L00rdD/bifrost/dashboard/bifrost-discord.png

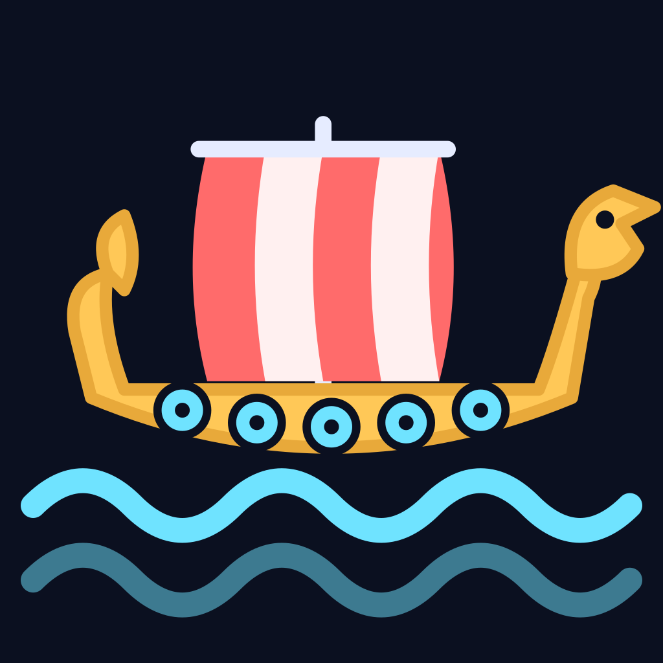
dashboard/bifrost-discord.png
