L00rdD/bifrost/dashboard/bifrost.png

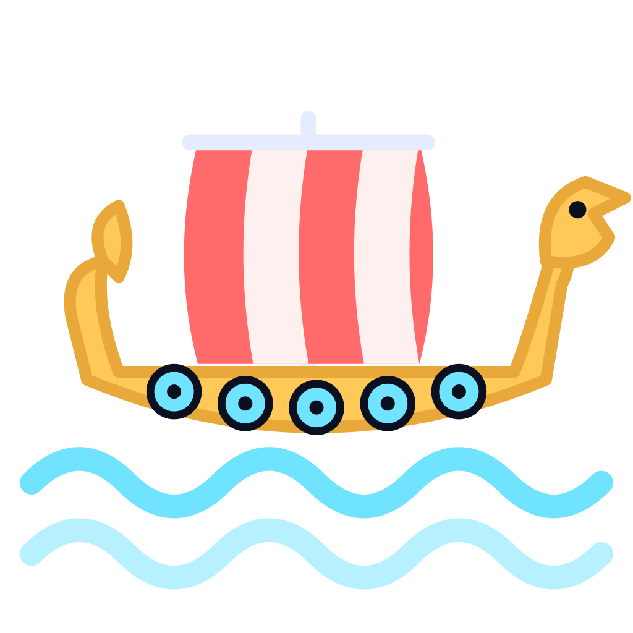
dashboard/bifrost.png
