L00rdD/bifrost/enclosure/renders/front.png

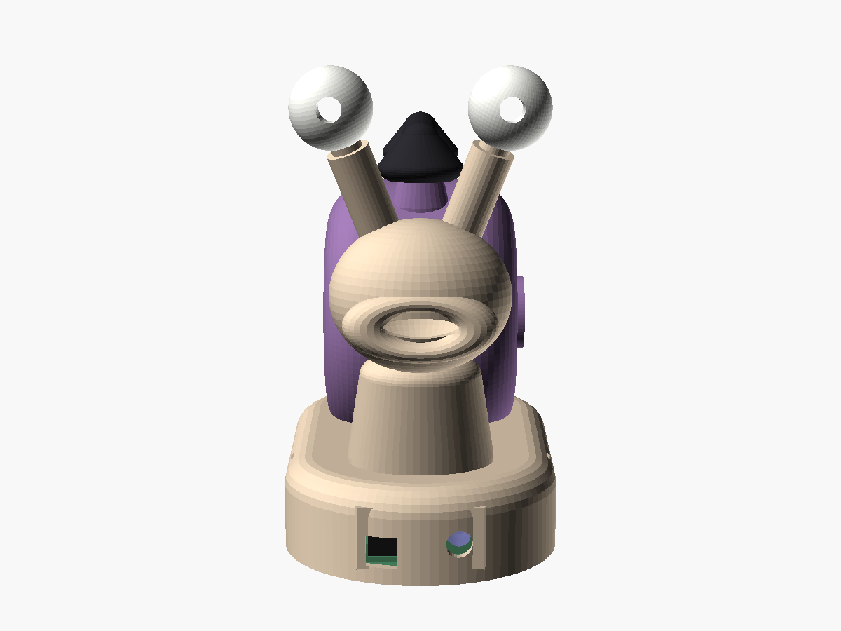
enclosure/renders/front.png
