L00rdD/bifrost/enclosure/renders/right.png

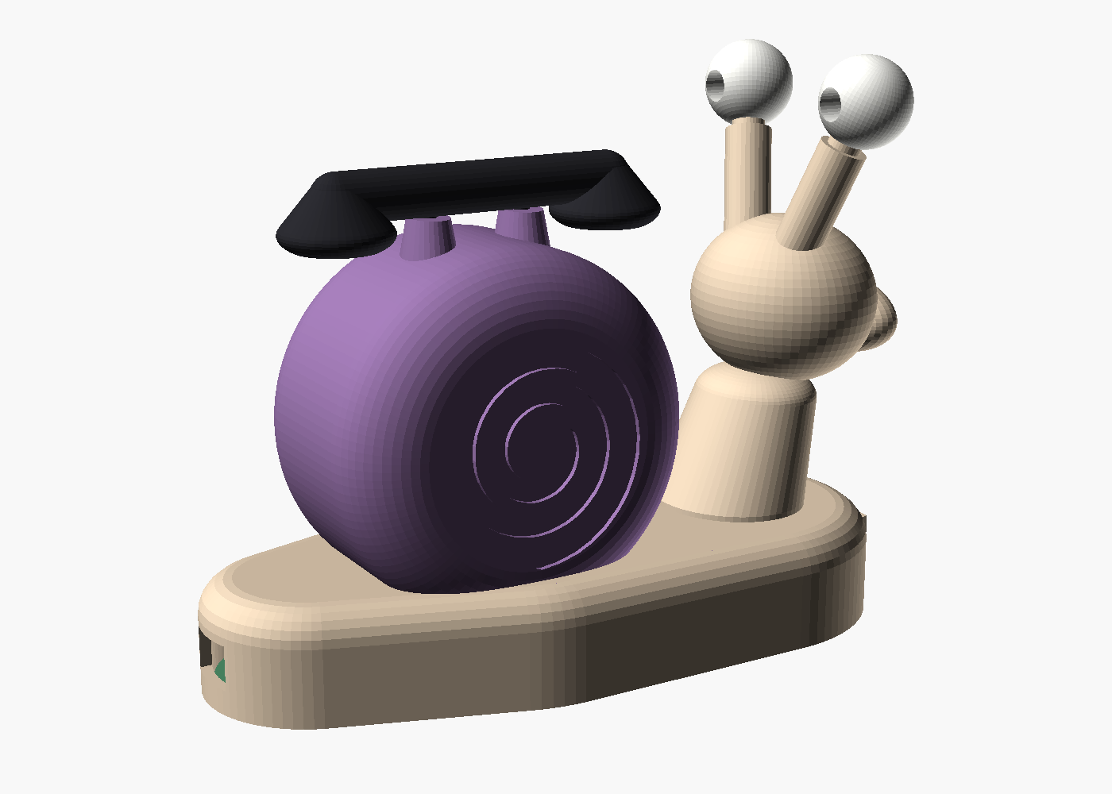
enclosure/renders/right.png
