L00rdD/bifrost/enclosure/shanks/out/all_back.png

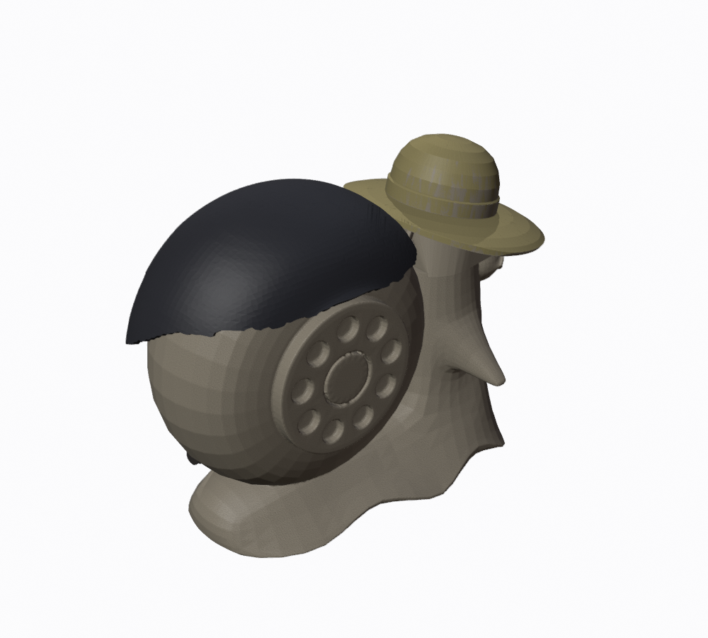
enclosure/shanks/out/all_back.png
