L00rdD/bifrost/enclosure/shanks/out/all_front.png

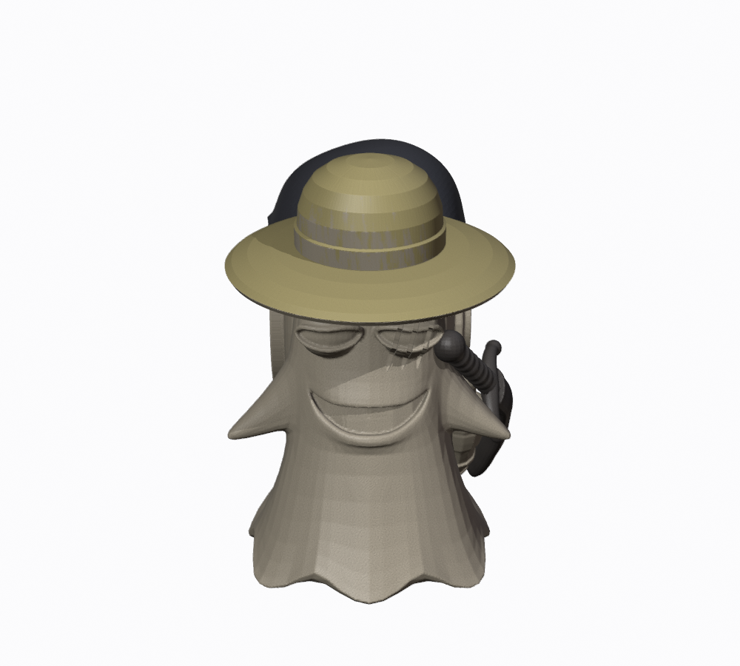
enclosure/shanks/out/all_front.png
