L00rdD/bifrost/enclosure/shanks/out/all_left.png

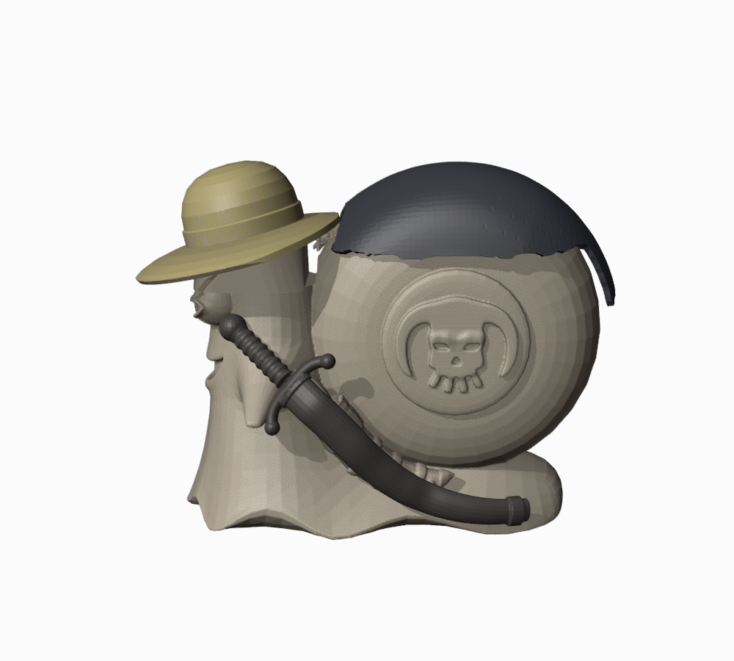
enclosure/shanks/out/all_left.png
