L00rdD/bifrost/enclosure/shanks/out/all_right.png

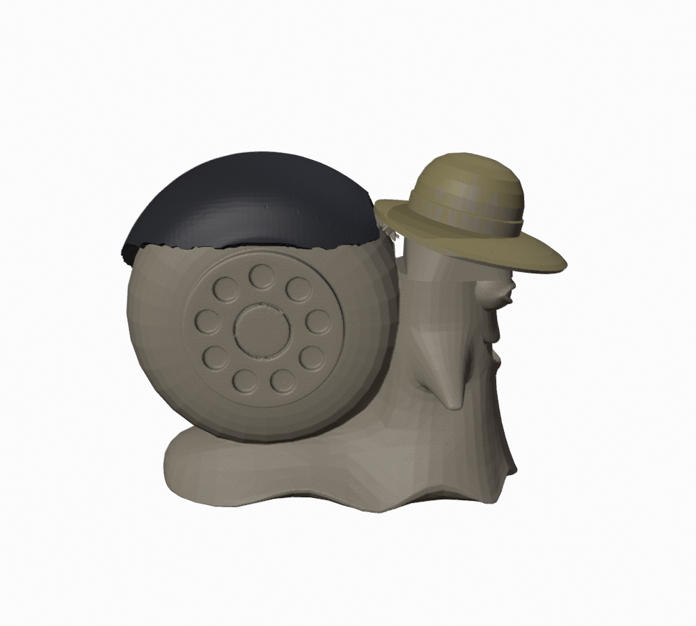
enclosure/shanks/out/all_right.png
