L00rdD/bifrost/enclosure/shanks/out/all_sword.png

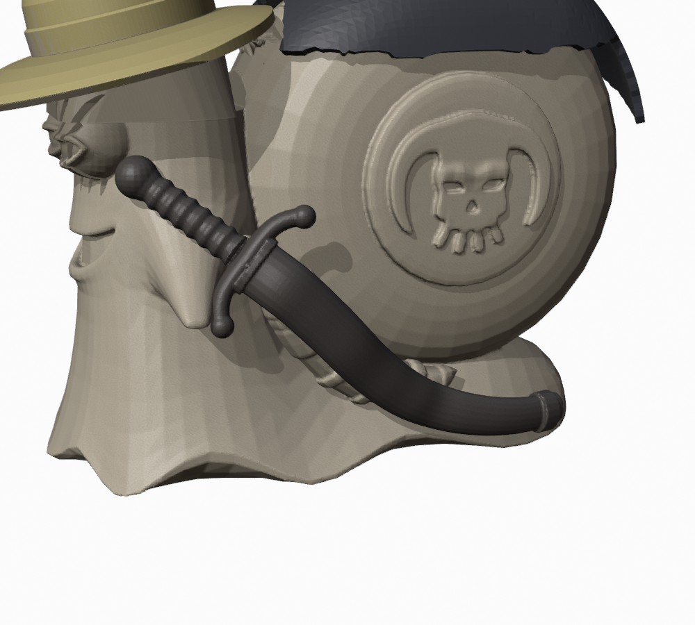
enclosure/shanks/out/all_sword.png
