L00rdD/bifrost/enclosure/shanks/out/all_three.png

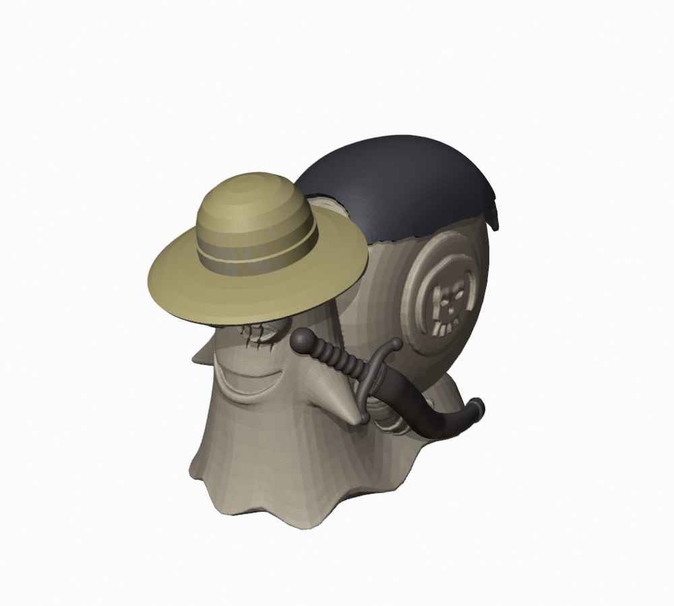
enclosure/shanks/out/all_three.png
