L00rdD/bifrost/enclosure/shanks/out/cape_back.png

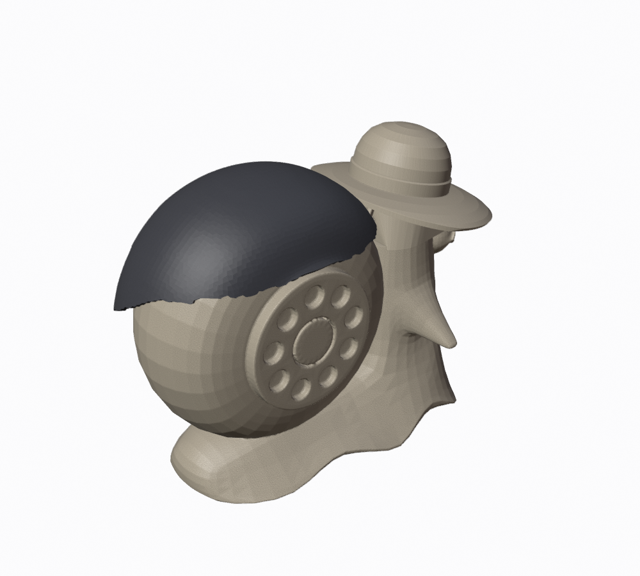
enclosure/shanks/out/cape_back.png
