L00rdD/bifrost/enclosure/shanks/out/cape_other.png

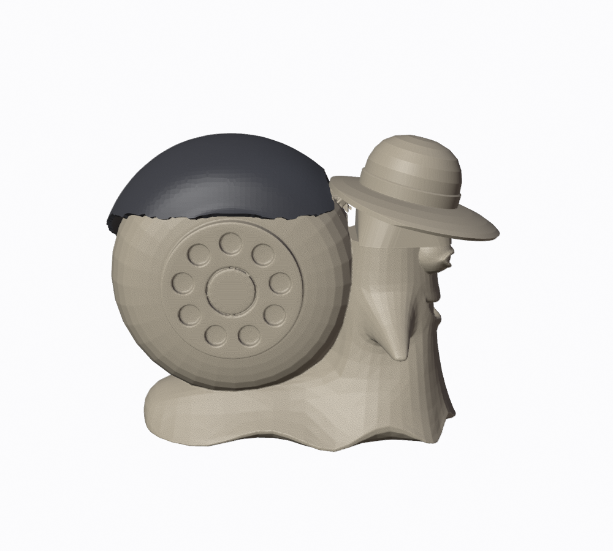
enclosure/shanks/out/cape_other.png
