L00rdD/bifrost/enclosure/shanks/out/cape_side.png

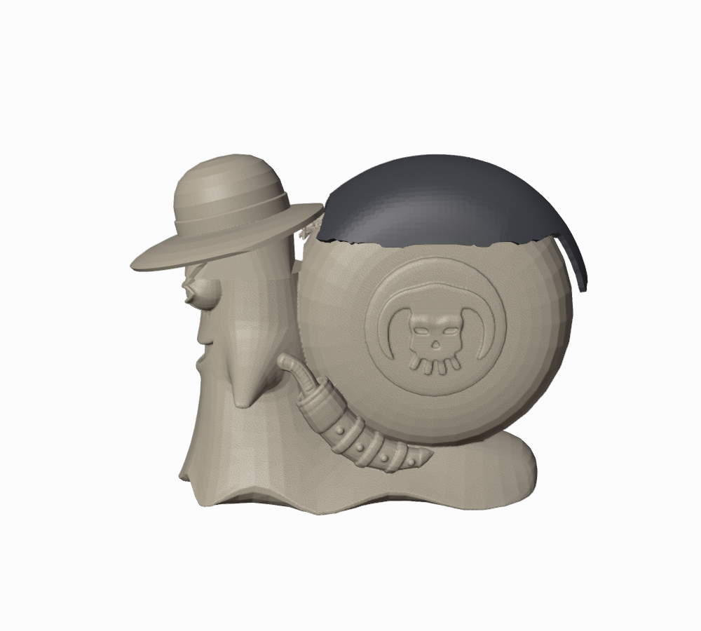
enclosure/shanks/out/cape_side.png
