L00rdD/bifrost/enclosure/shanks/out/preview_back.png

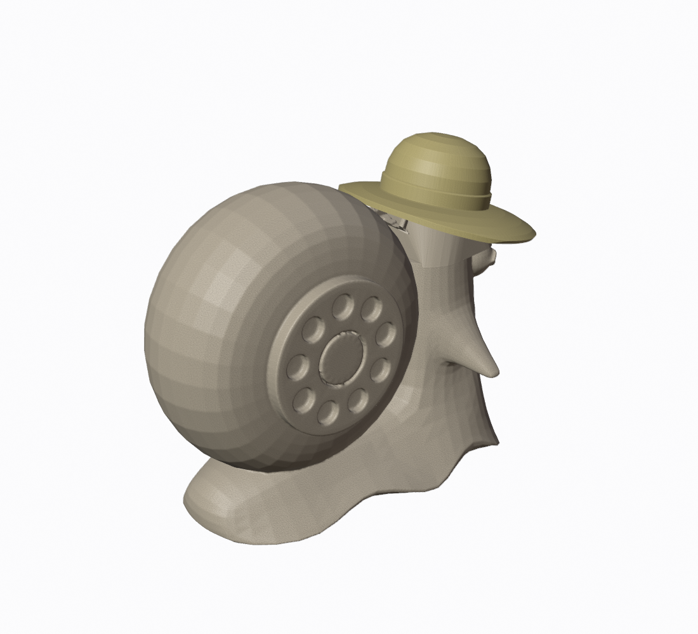
enclosure/shanks/out/preview_back.png
