L00rdD/bifrost/enclosure/shanks/out/preview_back_close.png

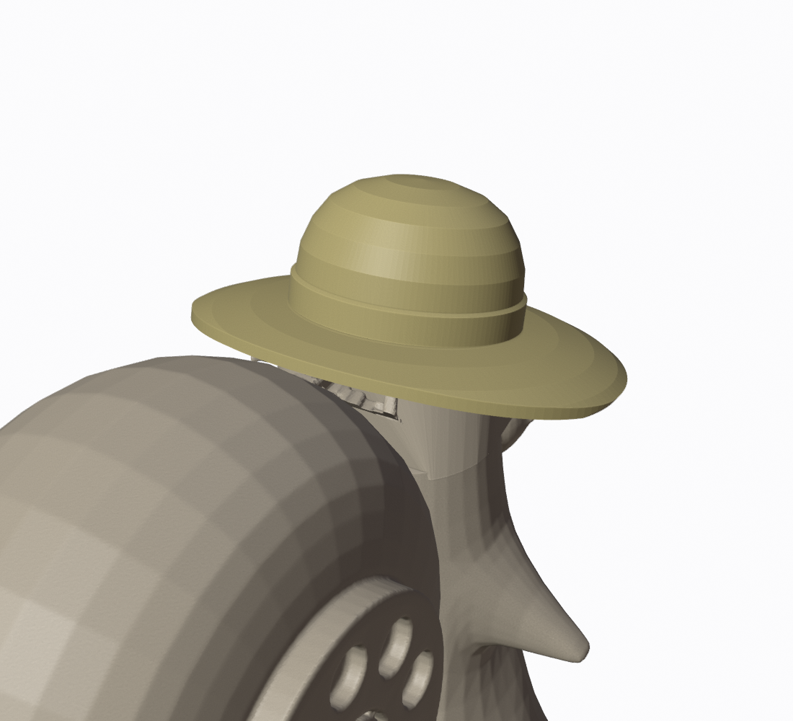
enclosure/shanks/out/preview_back_close.png
