L00rdD/bifrost/enclosure/shanks/out/preview_face_close.png

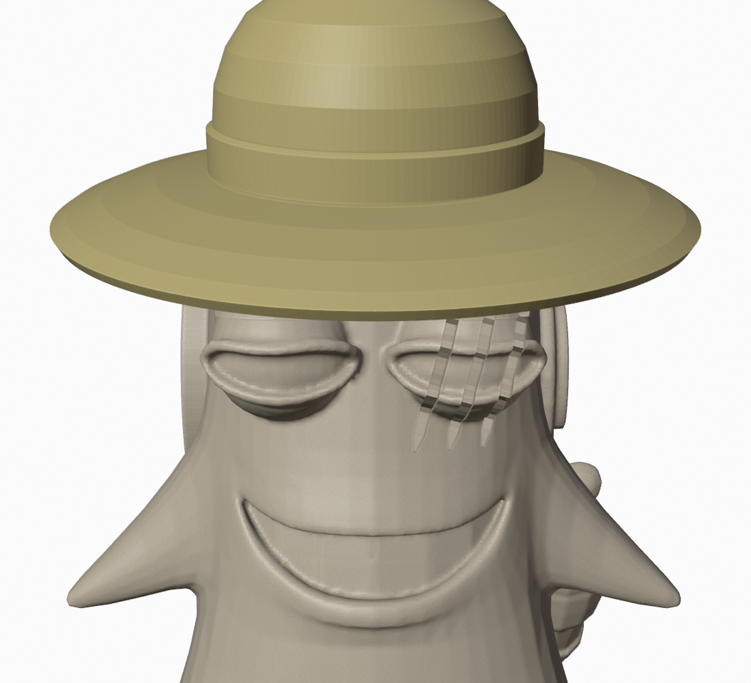
enclosure/shanks/out/preview_face_close.png
