L00rdD/bifrost/enclosure/shanks/out/preview_front.png

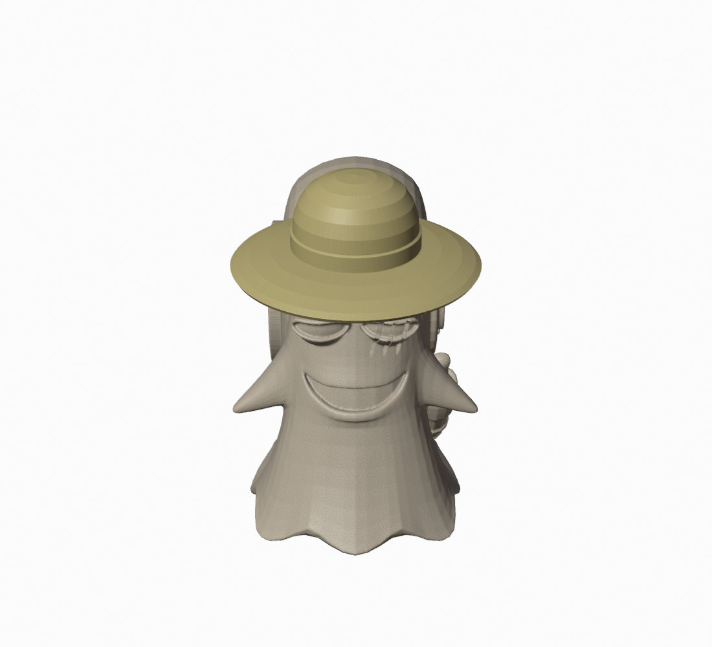
enclosure/shanks/out/preview_front.png
