L00rdD/bifrost/enclosure/shanks/out/preview_left_close.png

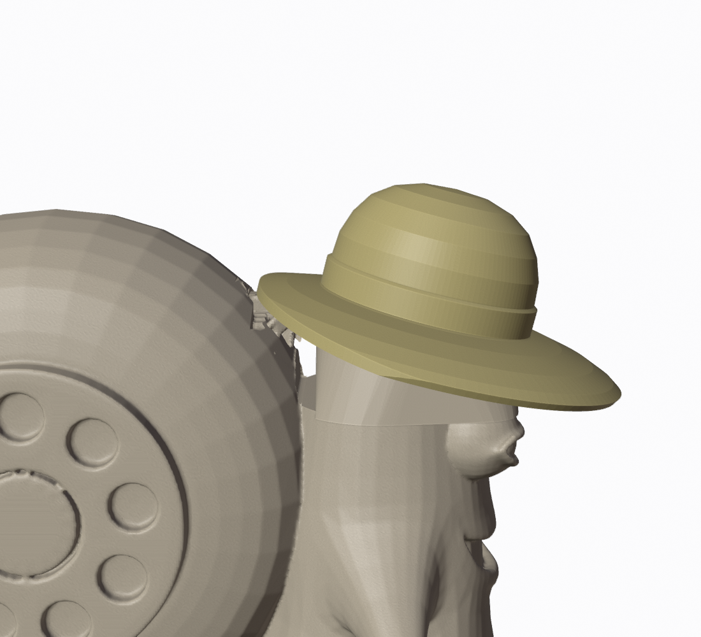
enclosure/shanks/out/preview_left_close.png
