L00rdD/bifrost/enclosure/shanks/out/preview_side.png

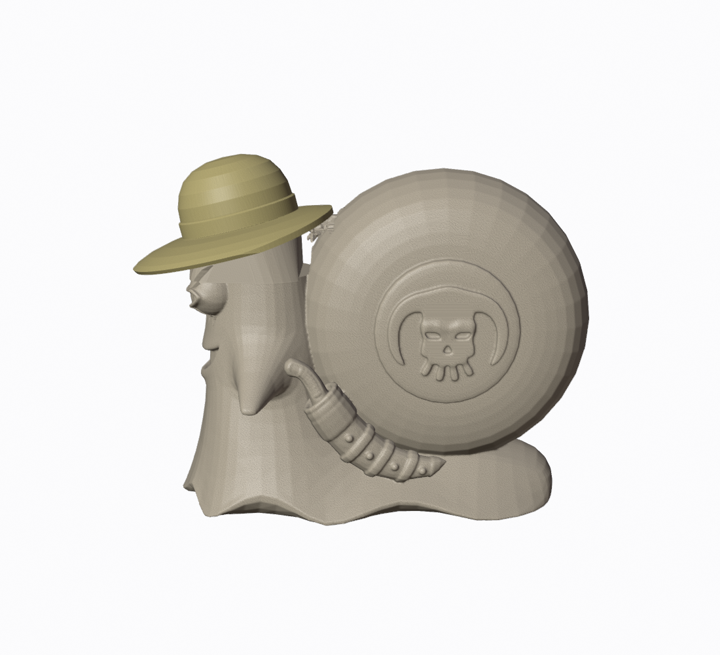
enclosure/shanks/out/preview_side.png
