L00rdD/bifrost/enclosure/shanks/out/preview_side_close.png

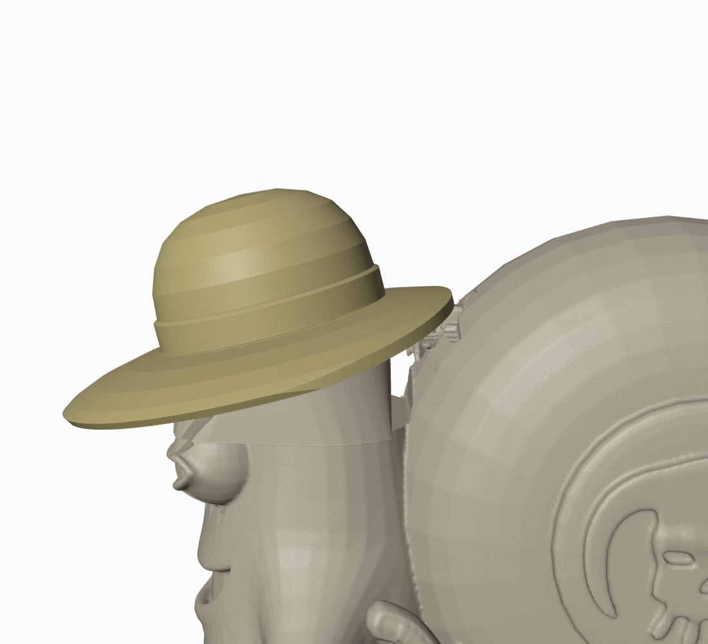
enclosure/shanks/out/preview_side_close.png
