L00rdD/bifrost/enclosure/shanks/out/preview_three.png

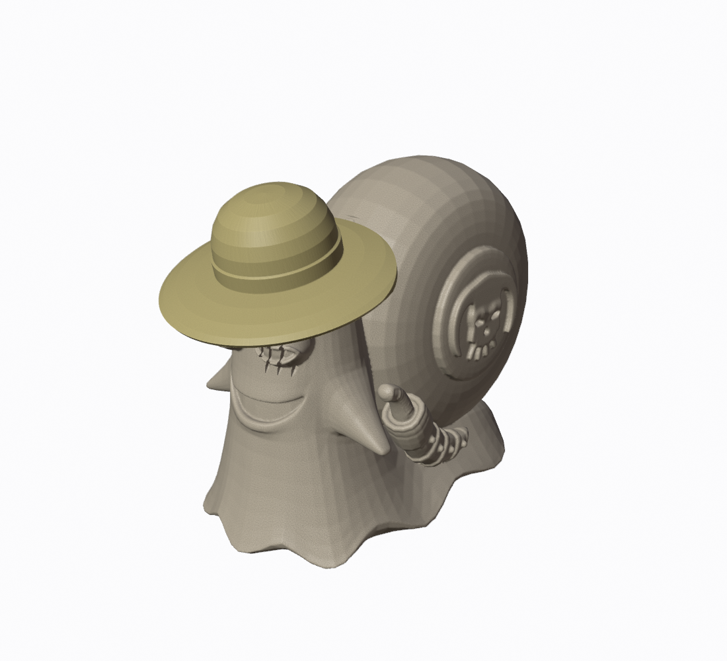
enclosure/shanks/out/preview_three.png
