L00rdD/bifrost/enclosure/stl/eye_left.stl

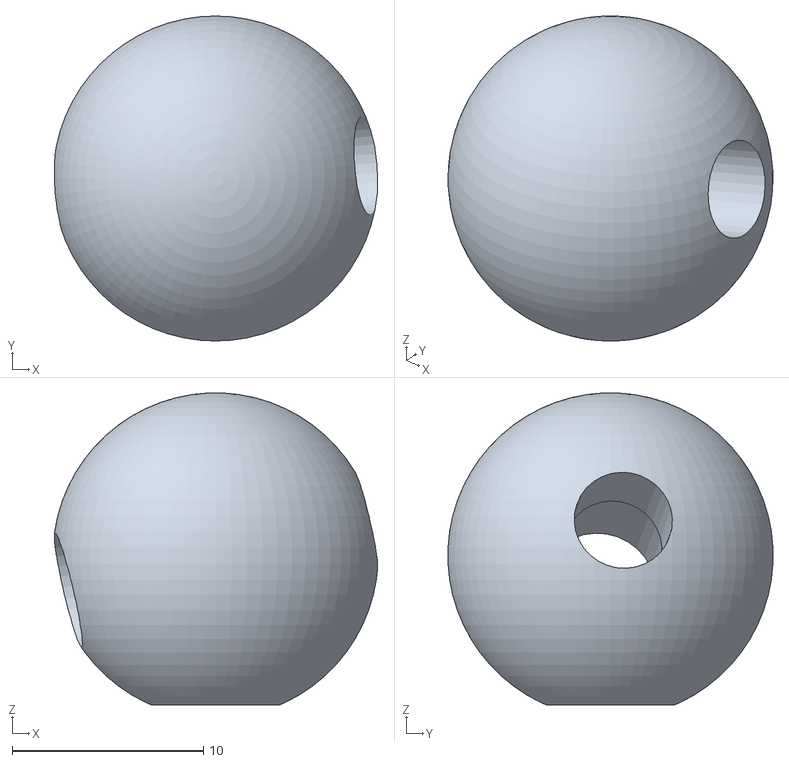
[picture p25: CAD file, 2026-10-26]
enclosure/stl/eye_left.stl
16.9 x 17.0 x 16.3
