L00rdD/bifrost/enclosure/stl/cradle.stl

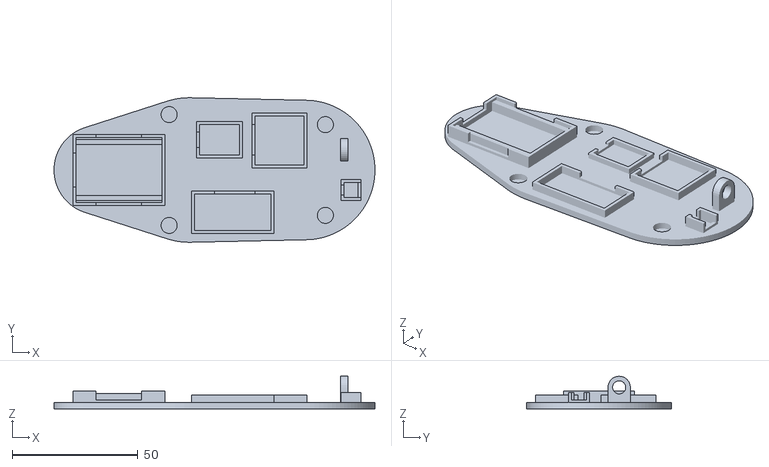
[picture p26: CAD file, 2026-10-26]
enclosure/stl/cradle.stl
127.4 x 57.4 x 12.9
