L00rdD/bifrost/enclosure/stl/body.stl

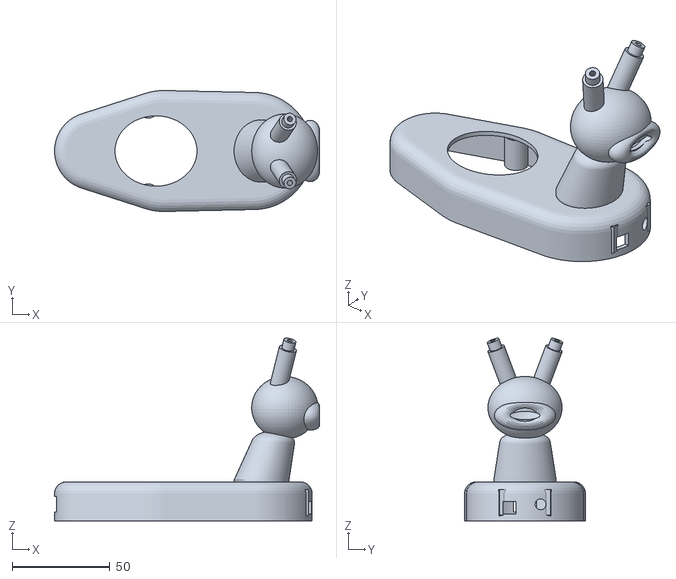
[picture p27: CAD file, 2026-10-26]
enclosure/stl/body.stl
135.8 x 62.0 x 93.7
