L00rdD/bifrost/enclosure/stl/handset.stl

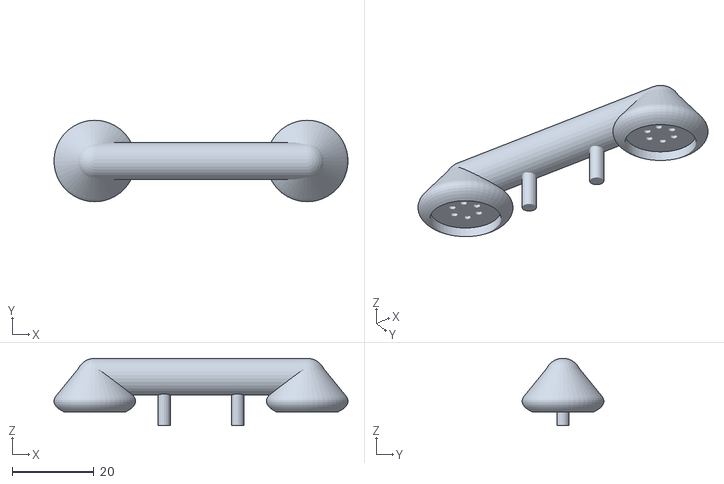
[picture p28: CAD file, 2026-10-26]
enclosure/stl/handset.stl
72.0 x 20.0 x 16.5
