L00rdD/bifrost/enclosure/stl/shell.stl

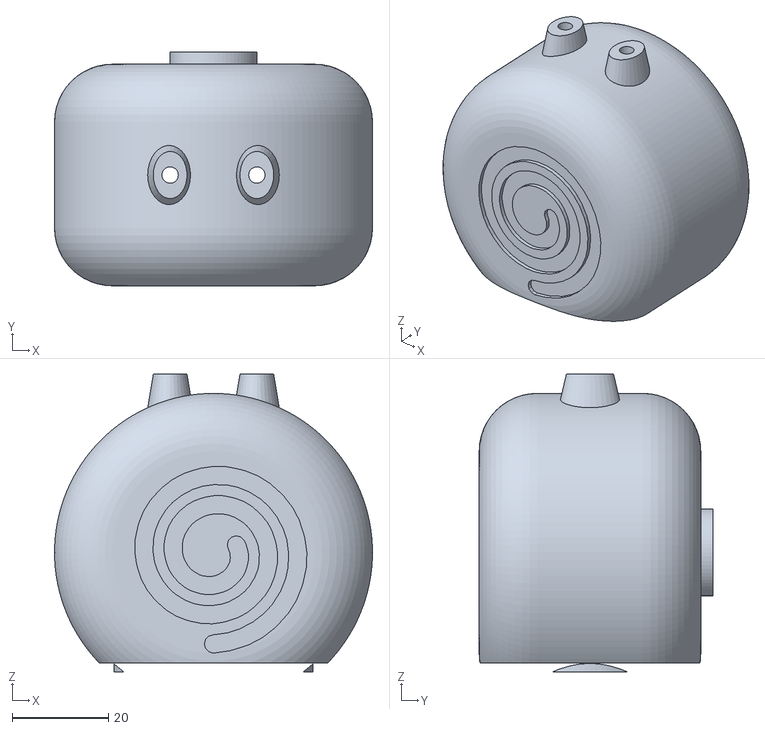
[picture p29: CAD file, 2026-10-26]
enclosure/stl/shell.stl
66.0 x 48.5 x 61.8
