L00rdD/bifrost/enclosure/shanks/out/cradle_outline.scad

// generated by tech.py: the floor opening of the hollow snail, and its magnet bosses
floor_z = 3.5;
opening = [[29.12, 81.20], [29.19, 81.11], [29.33, 80.93], [29.52, 80.70], [29.66, 80.51], [29.87, 80.22], [29.95, 80.10], [30.07, 79.90], [30.15, 79.77], [30.33, 79.48], [30.44, 79.29], [30.61, 79.00], [30.73, 78.81], [30.81, 78.69], [30.89, 78.54], [31.08, 78.22], [31.16, 78.10], [31.28, 77.90], [31.35, 77.77], [31.53, 77.49], [31.53, 77.49], [31.65, 77.30], [31.82, 77.01], [31.93, 76.83], [32.03, 76.69], [32.12, 76.53], [32.33, 76.20], [32.33, 76.20], [32.50, 75.90], [32.56, 75.79], [32.71, 75.51], [32.77, 75.40], [32.91, 75.10], [32.96, 74.99], [33.11, 74.68], [33.15, 74.60], [33.29, 74.30], [33.35, 74.18], [33.52, 73.82], [33.53, 73.80], [33.67, 73.49], [33.74, 73.36], [33.91, 73.00], [33.92, 72.97], [34.06, 72.69], [34.12, 72.54], [34.29, 72.20], [34.32, 72.13], [34.44, 71.88], [34.51, 71.72], [34.67, 71.40], [34.72, 71.28], [34.82, 71.07], [34.88, 70.93], [35.01, 70.62], [35.13, 70.32], [35.18, 70.20], [35.29, 69.90], [35.34, 69.77], [35.48, 69.40], [35.52, 69.29], [35.61, 69.05], [35.66, 68.90], [35.77, 68.60], [35.92, 68.21], [35.93, 68.20], [36.04, 67.87], [36.08, 67.74], [36.21, 67.42], [36.33, 67.08], [36.36, 67.00], [36.45, 66.69], [36.49, 66.58], [36.57, 66.20], [36.64, 65.80], [36.72, 65.44], [36.84, 65.33], [36.88, 65.00], [36.92, 64.60], [37.01, 64.16], [37.06, 64.13], [37.13, 63.80], [37.23, 63.40], [37.28, 63.00], [37.23, 62.60], [37.05, 62.20], [37.00, 62.11], [36.77, 61.80], [36.60, 61.52], [36.51, 61.40], [36.29, 61.00], [36.20, 60.82], [36.09, 60.60], [35.89, 60.20], [35.80, 60.00], [35.69, 59.80], [35.48, 59.40], [35.40, 59.25], [35.26, 59.00], [35.03, 58.60], [35.00, 58.55], [34.80, 58.20], [34.60, 57.86], [34.57, 57.80], [34.34, 57.40], [34.20, 57.16], [34.10, 57.00], [33.88, 56.60], [33.80, 56.42], [33.70, 56.20], [33.59, 55.80], [33.52, 55.40], [33.46, 55.00], [33.41, 54.60], [33.40, 54.53], [33.35, 54.20], [33.29, 53.80], [33.22, 53.40], [33.13, 52.99], [33.05, 52.60], [33.00, 52.40], [32.95, 52.20], [32.84, 51.80], [32.72, 51.40], [32.62, 51.00], [32.60, 50.85], [32.56, 50.60], [32.55, 50.20], [32.57, 49.80], [32.59, 49.40], [32.60, 49.12], [32.61, 49.00], [32.63, 48.60], [32.65, 48.20], [32.67, 47.80], [32.68, 47.40], [32.71, 47.00], [32.72, 46.60], [32.72, 46.20], [32.74, 45.80], [32.80, 45.41], [32.93, 45.00], [33.00, 44.83], [33.11, 44.59], [33.30, 44.20], [33.40, 43.99], [33.49, 43.79], [33.67, 43.40], [33.80, 43.10], [33.84, 43.00], [34.00, 42.60], [34.15, 42.20], [34.20, 42.06], [34.30, 41.80], [34.44, 41.40], [34.60, 41.00], [34.60, 41.00], [34.80, 40.60], [35.00, 40.30], [35.06, 40.20], [35.36, 39.80], [35.40, 39.75], [35.68, 39.40], [35.80, 39.26], [36.00, 39.02], [36.21, 38.75], [36.33, 38.60], [36.60, 38.27], [36.66, 38.20], [36.98, 37.80], [37.00, 37.78], [37.28, 37.40], [37.40, 37.24], [37.55, 37.00], [37.80, 36.64], [37.83, 36.60], [38.05, 36.21], [38.21, 35.96], [38.32, 35.80], [38.56, 35.40], [38.60, 35.33], [38.75, 35.00], [38.97, 34.60], [39.00, 34.55], [39.14, 34.20], [39.30, 33.82], [39.42, 33.60], [39.50, 33.40], [39.68, 33.01], [39.81, 32.75], [39.90, 32.59], [40.18, 32.20], [40.20, 32.17], [40.58, 31.80], [40.60, 31.78], [41.00, 31.46], [41.06, 31.40], [41.40, 31.02], [41.41, 31.00], [41.55, 30.60], [41.60, 30.20], [41.67, 29.80], [41.74, 29.43], [41.82, 29.24], [41.89, 29.00], [41.96, 28.60], [42.01, 28.20], [42.04, 27.80], [42.08, 27.40], [42.10, 27.23], [42.10, 27.00], [42.11, 26.60], [42.12, 26.30], [42.11, 26.20], [42.03, 25.80], [41.82, 25.40], [41.80, 25.38], [41.40, 25.06], [41.34, 25.00], [41.03, 24.60], [41.00, 24.54], [40.85, 24.20], [40.72, 23.80], [40.61, 23.40], [40.60, 23.38], [40.49, 23.00], [40.36, 22.60], [40.21, 22.40], [40.06, 22.19], [39.80, 21.96], [39.65, 21.80], [39.41, 21.53], [39.31, 21.40], [39.07, 21.00], [39.00, 20.85], [38.90, 20.62], [38.74, 20.20], [38.62, 19.89], [38.58, 19.79], [38.44, 19.40], [38.29, 19.00], [38.21, 18.80], [38.12, 18.60], [37.97, 18.20], [37.80, 17.80], [37.80, 17.80], [37.59, 17.41], [37.40, 17.04], [37.38, 17.00], [37.11, 16.60], [37.00, 16.44], [36.83, 16.20], [36.60, 15.87], [36.56, 15.80], [36.33, 15.40], [36.20, 15.12], [36.15, 15.00], [36.03, 14.60], [35.92, 14.20], [35.82, 13.80], [35.80, 13.72], [35.72, 13.40], [35.63, 13.01], [35.52, 12.60], [35.41, 12.20], [35.40, 12.19], [35.29, 11.79], [35.20, 11.40], [35.12, 11.00], [35.06, 10.60], [35.00, 10.22], [35.00, 10.20], [34.93, 9.80], [34.88, 9.42], [34.82, 9.00], [34.76, 8.60], [34.73, 8.20], [34.71, 7.80], [34.71, 7.40], [34.71, 7.00], [34.72, 6.60], [34.73, 6.20], [34.74, 5.80], [34.76, 5.40], [34.81, 5.00], [34.86, 4.61], [34.90, 4.20], [34.84, 3.80], [34.71, 3.40], [34.60, 3.08], [34.57, 3.00], [34.42, 2.60], [34.28, 2.20], [34.20, 1.96], [34.12, 1.80], [33.95, 1.40], [33.80, 1.02], [33.78, 1.00], [33.41, 0.60], [33.40, 0.60], [33.39, 0.60], [33.00, 0.80], [32.63, 1.00], [32.60, 1.02], [32.20, 1.10], [31.80, 1.07], [31.53, 1.00], [31.40, 0.97], [31.00, 0.83], [30.60, 0.69], [30.33, 0.60], [30.20, 0.56], [29.80, 0.44], [29.40, 0.33], [29.00, 0.22], [28.94, 0.20], [28.59, 0.13], [28.20, 0.05], [27.80, -0.03], [27.40, -0.12], [27.22, -0.20], [26.99, -0.28], [26.60, -0.48], [26.40, -0.60], [26.20, -0.71], [25.80, -0.93], [25.66, -1.00], [25.40, -1.12], [25.00, -1.30], [24.78, -1.40], [24.60, -1.48], [24.20, -1.66], [23.91, -1.80], [23.80, -1.85], [23.40, -2.06], [23.15, -2.20], [23.00, -2.28], [22.60, -2.50], [22.42, -2.60], [22.20, -2.73], [21.80, -2.96], [21.75, -3.00], [21.40, -3.32], [21.34, -3.40], [21.11, -3.80], [21.00, -4.07], [20.95, -4.20], [20.81, -4.62], [20.69, -5.00], [20.60, -5.26], [20.55, -5.40], [20.40, -5.82], [20.27, -6.20], [20.20, -6.39], [20.10, -6.60], [19.91, -7.00], [19.80, -7.23], [19.70, -7.40], [19.46, -7.80], [19.41, -7.89], [19.14, -8.21], [19.00, -8.40], [18.79, -8.60], [18.60, -8.78], [18.36, -9.00], [18.20, -9.15], [17.93, -9.40], [17.80, -9.53], [17.59, -9.80], [17.40, -10.08], [17.32, -10.20], [17.08, -10.60], [17.00, -10.74], [16.60, -10.68], [16.55, -10.60], [16.33, -10.20], [16.20, -10.01], [16.05, -9.80], [15.80, -9.49], [15.72, -9.40], [15.40, -9.09], [15.31, -9.00], [15.00, -8.72], [14.88, -8.60], [14.60, -8.33], [14.51, -8.20], [14.20, -7.82], [14.19, -7.80], [13.99, -7.42], [13.79, -7.10], [13.73, -7.00], [13.57, -6.60], [13.40, -6.20], [13.40, -6.20], [13.26, -5.80], [13.13, -5.40], [13.00, -5.05], [12.98, -5.00], [12.85, -4.60], [12.71, -4.20], [12.60, -3.93], [12.54, -3.80], [12.30, -3.40], [12.20, -3.26], [11.91, -3.00], [11.80, -2.92], [11.40, -2.68], [11.25, -2.60], [11.00, -2.46], [10.60, -2.24], [10.52, -2.20], [10.20, -2.02], [9.80, -1.82], [9.76, -1.80], [9.40, -1.63], [9.00, -1.46], [8.88, -1.40], [8.60, -1.27], [8.20, -1.09], [8.01, -1.00], [7.80, -0.90], [7.40, -0.68], [7.29, -0.61], [6.98, -0.42], [6.60, -0.26], [6.43, -0.20], [6.20, -0.11], [5.80, -0.02], [5.39, 0.07], [5.00, 0.14], [4.73, 0.20], [4.60, 0.24], [4.20, 0.35], [3.80, 0.46], [3.40, 0.58], [3.35, 0.60], [3.00, 0.73], [2.60, 0.89], [2.27, 1.00], [2.20, 1.03], [1.80, 1.13], [1.40, 1.15], [1.00, 1.01], [0.98, 1.00], [0.60, 0.75], [0.20, 0.61], [-0.06, 1.00], [-0.20, 1.17], [-0.28, 1.40], [-0.42, 1.78], [-0.60, 2.19], [-0.61, 2.20], [-0.75, 2.60], [-0.88, 2.98], [-1.01, 3.31], [-1.04, 3.40], [-1.17, 3.80], [-1.23, 4.20], [-1.18, 4.60], [-1.12, 5.00], [-1.08, 5.40], [-1.06, 5.80], [-1.05, 6.20], [-1.05, 6.60], [-1.04, 7.00], [-1.04, 7.40], [-1.04, 7.80], [-1.06, 8.20], [-1.09, 8.60], [-1.15, 9.00], [-1.20, 9.40], [-1.26, 9.80], [-1.31, 10.18], [-1.38, 10.60], [-1.40, 10.70], [-1.45, 11.00], [-1.53, 11.40], [-1.63, 11.82], [-1.74, 12.20], [-1.80, 12.43], [-1.85, 12.60], [-1.96, 13.00], [-2.05, 13.40], [-2.15, 13.80], [-2.20, 14.02], [-2.24, 14.20], [-2.36, 14.61], [-2.49, 15.00], [-2.60, 15.26], [-2.67, 15.40], [-2.90, 15.80], [-3.00, 15.96], [-3.16, 16.19], [-3.40, 16.54], [-3.44, 16.60], [-3.70, 17.00], [-3.80, 17.16], [-3.92, 17.40], [-4.10, 17.79], [-4.21, 18.01], [-4.29, 18.20], [-4.45, 18.60], [-4.59, 18.97], [-4.63, 19.06], [-4.75, 19.40], [-4.90, 19.83], [-5.00, 20.08], [-5.05, 20.20], [-5.20, 20.60], [-5.37, 20.99], [-5.42, 21.08], [-5.63, 21.41], [-5.80, 21.63], [-5.96, 21.80], [-6.19, 22.04], [-6.37, 22.20], [-6.60, 22.51], [-6.67, 22.61], [-6.81, 23.00], [-6.92, 23.40], [-7.00, 23.65], [-7.05, 23.80], [-7.19, 24.20], [-7.38, 24.60], [-7.40, 24.64], [-7.68, 25.00], [-7.80, 25.11], [-8.13, 25.40], [-8.20, 25.45], [-8.39, 25.80], [-8.46, 26.20], [-8.46, 26.60], [-8.44, 27.00], [-8.40, 27.40], [-8.36, 27.80], [-8.31, 28.20], [-8.25, 28.60], [-8.22, 28.80], [-8.14, 29.02], [-8.08, 29.40], [-8.02, 29.80], [-7.96, 30.20], [-7.89, 30.60], [-7.82, 30.79], [-7.68, 31.02], [-7.40, 31.40], [-7.40, 31.40], [-7.00, 31.71], [-6.90, 31.80], [-6.62, 32.05], [-6.47, 32.22], [-6.21, 32.60], [-6.20, 32.61], [-6.01, 32.99], [-5.83, 33.40], [-5.80, 33.46], [-5.64, 33.80], [-5.48, 34.20], [-5.41, 34.35], [-5.26, 34.62], [-5.08, 35.00], [-5.00, 35.18], [-4.86, 35.40], [-4.64, 35.80], [-4.60, 35.86], [-4.38, 36.20], [-4.20, 36.50], [-4.13, 36.60], [-3.88, 36.99], [-3.81, 37.10], [-3.58, 37.41], [-3.40, 37.66], [-3.29, 37.80], [-3.00, 38.17], [-2.97, 38.20], [-2.66, 38.60], [-2.60, 38.67], [-2.33, 39.01], [-2.21, 39.15], [-1.99, 39.42], [-1.80, 39.66], [-1.69, 39.80], [-1.40, 40.18], [-1.38, 40.20], [-1.12, 40.61], [-1.00, 40.85], [-0.93, 41.00], [-0.77, 41.40], [-0.62, 41.80], [-0.60, 41.85], [-0.47, 42.20], [-0.32, 42.60], [-0.20, 42.90], [-0.16, 43.00], [0.02, 43.41], [0.19, 43.80], [0.20, 43.82], [0.39, 44.21], [0.57, 44.60], [0.60, 44.65], [0.76, 45.02], [0.87, 45.40], [0.93, 45.80], [0.95, 46.20], [0.96, 46.60], [0.97, 47.00], [0.99, 47.40], [1.00, 47.66], [1.01, 47.80], [1.03, 48.20], [1.05, 48.60], [1.07, 49.00], [1.09, 49.40], [1.11, 49.80], [1.12, 50.20], [1.11, 50.60], [1.05, 51.00], [1.00, 51.18], [0.94, 51.40], [0.83, 51.79], [0.72, 52.20], [0.62, 52.60], [0.60, 52.67], [0.53, 53.00], [0.45, 53.40], [0.38, 53.80], [0.32, 54.20], [0.26, 54.60], [0.21, 55.00], [0.20, 55.09], [0.16, 55.40], [0.09, 55.80], [-0.04, 56.20], [-0.20, 56.56], [-0.22, 56.60], [-0.43, 57.00], [-0.60, 57.29], [-0.66, 57.40], [-0.90, 57.80], [-1.00, 57.98], [-1.13, 58.20], [-1.36, 58.60], [-1.40, 58.67], [-1.59, 59.00], [-1.80, 59.37], [-1.81, 59.40], [-2.03, 59.80], [-2.20, 60.13], [-2.24, 60.20], [-2.42, 60.60], [-2.60, 60.94], [-2.63, 61.00], [-2.85, 61.40], [-3.00, 61.60], [-3.11, 61.80], [-3.35, 62.17], [-3.43, 62.27], [-3.58, 62.60], [-3.61, 63.00], [-3.54, 63.40], [-3.46, 63.75], [-3.42, 63.78], [-3.33, 64.20], [-3.28, 64.60], [-3.24, 65.00], [-3.24, 65.02], [-3.16, 65.30], [-3.06, 65.39], [-2.98, 65.80], [-2.92, 66.20], [-2.86, 66.52], [-2.80, 66.66], [-2.73, 66.88], [-2.69, 67.00], [-2.54, 67.38], [-2.50, 67.50], [-2.39, 67.80], [-2.32, 68.00], [-2.25, 68.20], [-2.12, 68.54], [-2.07, 68.68], [-1.96, 69.00], [-1.93, 69.08], [-1.80, 69.41], [-1.68, 69.73], [-1.63, 69.86], [-1.52, 70.15], [-1.50, 70.20], [-1.35, 70.58], [-1.30, 70.70], [-1.17, 71.00], [-1.13, 71.10], [-0.98, 71.41], [-0.85, 71.69], [-0.78, 71.85], [-0.73, 71.96], [-0.60, 72.21], [-0.46, 72.51], [-0.39, 72.66], [-0.33, 72.79], [-0.22, 73.02], [-0.07, 73.32], [-0.01, 73.47], [0.06, 73.62], [0.16, 73.82], [0.31, 74.14], [0.37, 74.27], [0.48, 74.49], [0.53, 74.60], [0.68, 74.93], [0.76, 75.08], [0.87, 75.33], [0.91, 75.40], [1.08, 75.73], [1.16, 75.89], [1.26, 76.05], [1.36, 76.22], [1.54, 76.51], [1.64, 76.68], [1.68, 76.75], [1.83, 76.99], [1.90, 77.10], [2.04, 77.32], [2.11, 77.43], [2.30, 77.75], [2.39, 77.89], [2.47, 78.02], [2.58, 78.21], [2.76, 78.50], [2.87, 78.69], [3.04, 78.97], [3.12, 79.10], [3.24, 79.31], [3.31, 79.42], [3.51, 79.75], [3.59, 79.89], [3.67, 80.01], [3.80, 80.20], [3.97, 80.45], [4.13, 80.65], [4.33, 80.92], [4.48, 81.10], [4.67, 81.34], [4.80, 81.51], [4.88, 81.62], [5.02, 81.79], [5.10, 81.90], [5.26, 82.11], [5.34, 82.21], [5.54, 82.48], [5.69, 82.69], [5.90, 82.96], [6.01, 83.12], [6.07, 83.20], [6.22, 83.39], [6.31, 83.50], [6.51, 83.71], [6.60, 83.80], [6.69, 83.90], [6.89, 84.08], [7.02, 84.18], [7.23, 84.38], [7.41, 84.50], [7.73, 84.72], [7.93, 84.84], [8.20, 84.96], [8.62, 85.12], [8.72, 85.18], [8.85, 85.22], [8.99, 85.26], [9.40, 85.38], [9.81, 85.51], [9.91, 85.57], [10.06, 85.62], [10.22, 85.65], [10.60, 85.74], [11.00, 85.83], [11.39, 85.92], [11.49, 85.96], [11.76, 86.03], [11.80, 86.04], [12.20, 86.09], [12.60, 86.16], [13.00, 86.21], [13.40, 86.25], [13.82, 86.31], [13.89, 86.33], [14.20, 86.36], [14.60, 86.40], [15.00, 86.43], [15.12, 86.44], [15.40, 86.44], [15.80, 86.45], [16.20, 86.45], [16.60, 86.45], [17.00, 86.45], [17.40, 86.45], [17.80, 86.45], [18.20, 86.45], [18.57, 86.44], [18.60, 86.43], [19.00, 86.41], [19.40, 86.37], [19.72, 86.34], [19.80, 86.31], [20.20, 86.26], [20.60, 86.22], [21.00, 86.17], [21.41, 86.11], [21.80, 86.05], [21.92, 86.03], [22.12, 85.98], [22.24, 85.93], [22.60, 85.84], [23.00, 85.76], [23.39, 85.66], [23.61, 85.63], [23.69, 85.60], [23.82, 85.53], [24.20, 85.41], [24.61, 85.28], [24.83, 85.22], [24.86, 85.21], [25.01, 85.13], [25.40, 84.99], [25.71, 84.86], [25.91, 84.74], [26.20, 84.55], [26.41, 84.41], [26.61, 84.23], [26.84, 84.03], [27.04, 83.84], [27.24, 83.64], [27.44, 83.40], [27.54, 83.28], [27.68, 83.10], [27.77, 82.98], [27.95, 82.74], [27.96, 82.73], [28.09, 82.55], [28.29, 82.27], [28.45, 82.06], [28.65, 81.80], [28.74, 81.68], [28.88, 81.50], [28.97, 81.38]];
bosses = [[-2.92, 2.00], [36.59, 2.00], [-1.70, 36.00], [35.37, 36.00]];
