L00rdD/bifrost/(list of files, cad)

Other CAD files:
enclosure/stl/eye_right.stl
