L00rdD/bifrost/(commit log)

2026-10-25 Bridge 433 MHz outlets to MQTT and HomeKit
    Mosquitto, Homebridge and a small hub run on the Pi next to
    d-mediaserver; an ESP8266 sends and hears the RF codes. The codes
    live in outlets.toml only, kept out of the repo like .env (anyone in
    radio range could switch the outlets with them): Homebridge, Sapling
    Sunrise and the home page card know an outlet by its id and talk to
    the hub over bifrost/outlet/<id>/set and /state.
    The firmware comes from domotics/rf_module/rf_sender, with repeated
    presses reported again, every sent code echoed on 433/receive, the
    protocol on 433/receive/raw, Wi-Fi diagnostics at boot and no
    password in the serial log.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
2026-10-25 Add a dashboard to switch the outlets from the browser
    The hub serves dashboard/ on :8582. Each outlet gets a switch that
    posts to /api/outlets/<id>, sends radio waves while the code is on its
    way, lights the bulb when the RF bridge echoes it back, and flips back
    after 6 s without an echo. A signal path shows HomeKit, the broker,
    the RF bridge and the air, with a packet of light for every code. The
    page takes the look of the media server hub when it answers.
    The POST takes JSON only and has no CORS header, so a page from
    another site cannot switch the outlets through a visitor's browser.
    Tests cover the hub's MQTT side, the web server and render.py.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
2026-10-25 Drive the projection screen by time, from HomeKit and the remote
    The screen's motor has up, stop and down buttons and no position. A
    [[cover]] in outlets.toml gives its codes and the times measured with a
    Flipper RAW capture; the hub sends down, then stop once that time is
    over, and closes into the top, where the motor stops by itself and the
    estimate starts from 0 again. Remote presses are followed, a new order
    mid-move goes through stop, and the position is kept retained on the
    broker for the next start.
    Homebridge gets a window covering per cover (100 % open = screen down),
    POST /api/covers/<id> moves it, and status.json lists the covers.
    The screen's remote pulses at 188 us, not 350: 4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
    [rf-bridge.ino]
2026-10-25 Show the projection screen on the dashboard
    A card draws the screen's cloth at the position the hub reckons, with
    the target dashed while it moves and the rainbow bridge brighter as it
    comes down. Close, stop and open buttons and a slider post to
    /api/covers/<id>; the page polls every second while a cover moves.
2026-10-25 Drive the projector over adb, and the screen with it
    The JMGO projector (Google TV) ignores the power keys of the Google TV
    remote protocol, so the hub drives it with adb: wake and sleep (not
    the power toggle), keys, and apps. Every 5 s it looks whether the
    projector is awake and which app is in front, publishes that retained,
    and moves the projector's cover: down when it turns on, up when it
    turns off, whoever turned it.
    Homebridge gets a television with the apps as inputs and the iPhone's
    remote. The dashboard gets a Cinema section with the projector, its
    apps and a small remote above the screen. Keys and packages are
    checked against strict patterns before they reach adb's shell.
    The hub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
2026-10-25 See the projector asleep instead of unreachable
    Asleep, no activity is resumed: the second grep of the probe found
    nothing and failed, adb shell passed its exit code on, and the hub took
    the projector for unreachable. It never saw it turn off, so the screen
    never went up. The probe now always exits 0 (its output says the state),
    and dumpsys no longer complains that grep -m1 closed the pipe.
2026-10-26 Stop the screen at close_time instead of running it into the top
    Closing ran the motor 2 s past the measured time (TOP_MARGIN) so that it
    stopped against the top by itself. The screen must not run into its end
    stop: closing now sends stop once close_time is over, like opening.
2026-10-26 Model a Den Den Mushi enclosure for the RF bridge
    An OpenSCAD transponder snail for the D1 mini, the 433 MHz transmitter
    and receiver and the IR LEDs, printed in resin: the parts as STL, the
    renders, and rendu.html, the illustrated guide to print and assemble it.
    [body.stl, cradle.stl, denden.scad, eye_left.stl, eye_right.stl, handset.stl, shell.stl]
2026-10-26 Let the RF bridge heal itself and take updates over Wi-Fi
    On 2026-10-26 the bridge stayed off the network after the Pi rebooted,
    until it was unplugged. It now keeps the Wi-Fi awake (modem sleep made the
    broker drop it for silence), tries the broker every 5 s without blocking
    the loop, and restarts after 2 min without Wi-Fi or broker. ArduinoOTA
    with OTA_PASS lets make ota flash it as rf-bridge.local, and 433/info
    (retained) tells which build runs, its IP and its signal.
    [rf-bridge.ino]
2026-10-26 Give the iPhone's volume buttons the projector's sound
    The volume buttons of the iOS remote go through the same list as its keys,
    0 louder and 1 quieter: they sent rewind and fast forward. The remote
    never sends those two, so they are the volume now. The dashboard's remote
    gets volume, mute and settings in its empty cells.
2026-10-27 Move the screen by hand and reset it when the hub lost track
    The hub reckons the screen by time: a code the screen never catches leaves
    it open while the hub says 0 %, and a close then does nothing. A Manual row
    on the dashboard sends up, down as the remote would, and Reset forgets the
    position, goes all the way up and starts again from 0. The same comes over
    MQTT (bifrost/cover/<id>/press, RESET on /set) and POST /api/covers/<id>.
    An up pressed with the position unknown now ends at 0 too.
2026-10-27 Stop a manual press by the hub once the measured time is over
    The motor never stops on its own, not even at the top: an up or down
    pressed from the dashboard ran until someone pressed stop. The hub now
    sends stop itself after close_time or open_time at the latest, and the
    docs no longer say the top stops the motor.
2026-10-28 Tell the hub where the screen is instead of resetting it
    Reset ran the motor a whole close_time to find the top, forcing against
    the end stop for whatever it did not need. Gone: "= rolled up" and
    "= open" on the dashboard (bifrost/cover/<id>/declare 0-100, {"declare":
    0} over POST) tell the hub where the screen really is, and nothing moves.
    A move under way gets its stop first.
2026-10-29 Wake the projector from deep sleep and show its screen on the dashboard
    Asleep for long, the projector's Wi-Fi lets adb through only now and then:
    an ON or OFF now tries again for 3 minutes, dropping the dead connection adb
    keeps between two tries, instead of giving up after one 10 s try.
    The projector card gets a Screen button: the hub runs the scrcpy server on
    the projector while someone watches, ffmpeg turns its H.264 into an MJPEG
    stream any browser shows, and a click on the picture taps the projector.
2026-10-29 Get pictures out of ffmpeg for the projector's screen
    The JPEG encoder refused the projector's limited-range colours, and with
    -fflags nobuffer or -flags low_delay ffmpeg put no picture out at all: the
    dashboard stayed blank. ffmpeg now converts to full range, keeps neither flag,
    and its errors reach the hub's log. A test runs the command through a real
    ffmpeg.
2026-11-01 Keep the projector in health, and focus it once the screen is down
    After nine days up, the projector stayed on but projected nothing: with
    under 2 GB for Google TV and the apps it starts by itself, memory runs
    short, Android kills com.jmgo.hippo (the process that drives the light
    and the lens), and only a restart brings the picture back.
    Every minute the hub now checks the projector: short of memory, it kills
    the apps left in the background; the vital process killed, the same, and
    a restart as soon as nobody watches. A restart also happens every night
    from reboot_at, nobody watching, and puts the projector back to sleep if
    it was off. No two restarts for health within an hour.
    The projecto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
2026-11-01 Offer the projector's home screen first, and tidy the enclosure renders
    The launcher comes first among the projector's apps, under its HomeKit
    name: opening it wakes the projector and sends HOME. The dashboard names
    the app in front from that list before falling back to home or
    screensaver. The enclosure's old render page gives way to the bamboo and
    bonsai renders.
2026-11-01 Model Shanks' Den Den Mushi in Blender for the RF bridge
    The Ace snail from Thingiverse with Luffy's straw hat, a cape and Gryphon,
    hollowed out and closed by a cradle that carries the electronics. The STLs
    are left out: the scripts regenerate them.
    [berceau.scad, cradle_outline.scad, shanks.scad]
2026-11-04 Pin down the hub's covers, messages, projector and POST before splitting them
    Characterisation tests for the branches the suite did not reach yet, and the
    projector tests no longer leave a focus timer firing into a later test.
2026-11-04 Split the snail's section walk, brim cut and sabre sweep into small steps
    Same meshes out: checked in Blender against the previous version on test
    solids (cut outlines, swept tube and brim cut identical).
2026-11-04 Test the dashboard's script on a fake page
    node --test tests/: what each card shows in every state, the orders its
    switches, buttons, slider, remote and live screen send, the polling and the
    failures. They pass on the script as it was inline in the page too.
2026-11-04 Split the dashboard's painting of the projector and of the status
    The projector's state in words and the chain, outlets, cinema and last code
    each get their own small function; the page shows the same.
2026-11-08 Give the screen the dashboard's buttons in HomeKit instead of a blind
2026-11-08 Name the screen's HomeKit buttons in French, as the rest of the Home app
2026-11-08 Show each of the screen's HomeKit buttons under its own name
